sinthi23/Solar_IOT_System/docs/project_setup.jpg

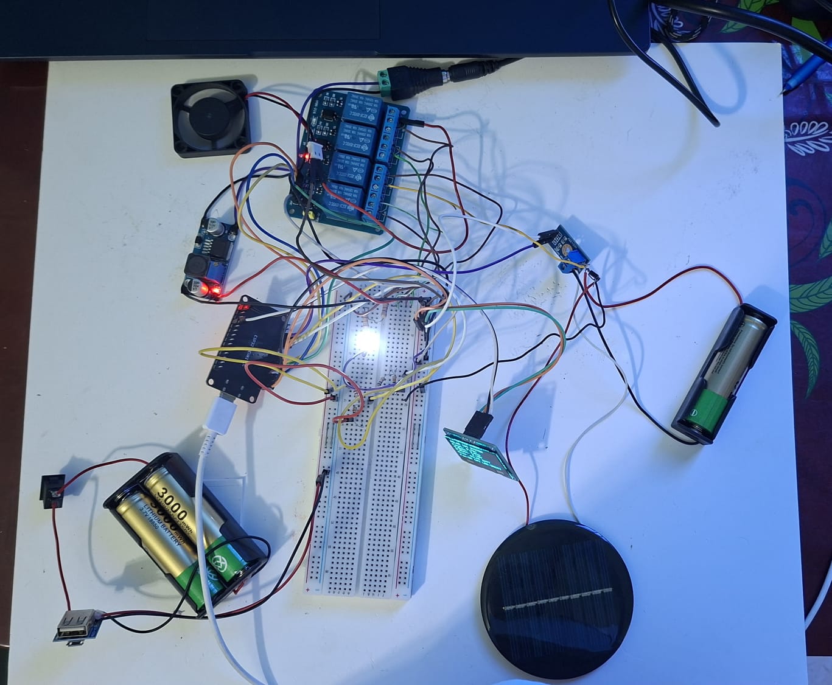
docs/project_setup.jpg
