sinthi23/Solar_IOT_System/(commit log)

2026-09-01 Update wording for calibration constants section
2026-09-02 Revise circuit diagram note in README
    Update README to reflect changes in project documentation.
2026-09-02 Change cooling fan voltage specification to 5V
    Updated cooling fan voltage from 12V to 5V in the components list.
